Pan-Maciek/k60/pcb/k60.brd

## EAGLE design pcb/k60.brd (2021-05-18)

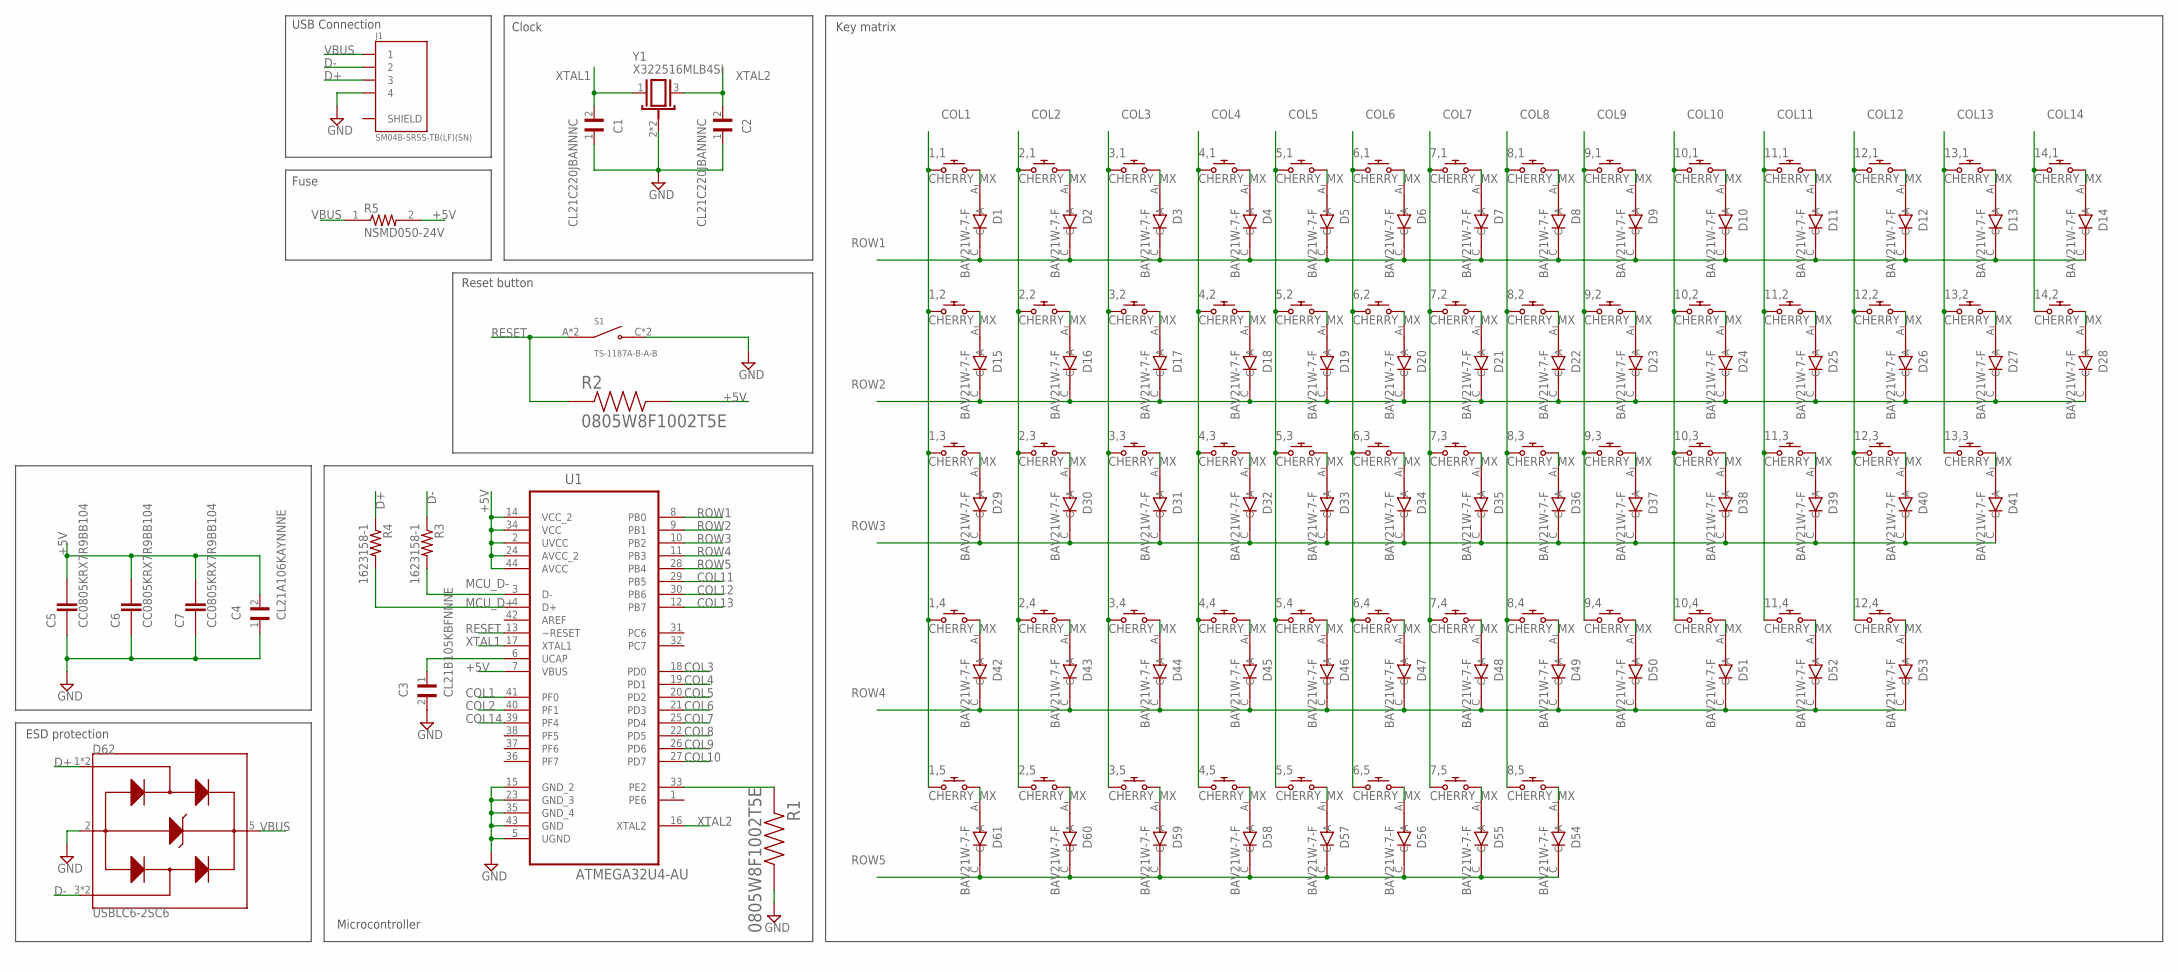
[picture p1: schematic k60.sch]

Parts:
1,1, 1,2, 1,3, 1,4, 1,5, 2,1, 2,2, 2,3, 2,4, 2,5, 3,1, 3,2, 3,3, 3,4, 3,5, 4,1, 4,2, 4,3, 4,4, 4,5, 5,1, 5,2, 5,3, 5,4, 5,5, 6,1, 6,2, 6,3, 6,4, 6,5, 7,1, 7,2, 7,3, 7,4, 7,5, 8,1, 8,2, 8,3, 8,4, 8,5, 9,1, 9,2, 9,3, 9,4, 10,1, 10,2, 10,3, 10,4, 11,1, 11,2, 11,3, 11,4, 12,1, 12,2, 12,3, 12,4, 13,1, 13,2, 13,3, 14,1, 14,2: CHERRY_MX
C1, C2: CL21C220JBANNNC; CAPC2012X140N
C3: CL21B105KBFNNNE; CL21B105KBFNNNE_CAPC2012X140N
C4: CL21A106KAYNNNE; CAPC2012X135N
C5, C6, C7: CC0805KRX7R9BB104; CAPC2012X70
D1, D2, D3, D4, D5, D6, D7, D8, D9, D10, D11, D12, D13, D14, D15, D16, D17, D18, D19, D20, D21, D22, D23, D24, D25, D26, D27, D28, D29, D30, D31, D32, D33, D34, D35, D36, D37, D38, D39, D40, D41, D42, D43, D44, D45, D46, D47, D48, D49, D50, D51, D52, D53, D54, D55, D56, D57, D58, D59, D60, D61: BAV21W-7-F; SOD3715X135N
D62: USBLC6-2SC6; SOT95P280X145-6N
J1: SM04B-SRSS-TB(LF)(SN); JST_SM04B-SRSS-TB(LF)(SN)
R1, R2: 0805W8F1002T5E; RESC2012X60N
R3, R4: 1623158-1; RESC2012X65N
R5: NSMD050-24V; RESC3115X65N
S1: TS-1187A-B-A-B; SW_TS-1187A-B-A-B
U1: ATMEGA32U4-AU; QFP80P1200X1200X120-44N
Y1: X322516MLB4SI; OSC_X322516MLB4SI

Connections:
+5V: C4.2, C5.2, C6.2, C7.2, R2.2, R5.2, U1.2 (UVCC), U1.7 (VBUS), U1.14 (VCC_2), U1.24 (AVCC_2), U1.34 (VCC), U1.44 (AVCC)
COL1: 1,1.S1 (1), 1,2.S1 (1), 1,3.S1 (1), 1,4.S1 (1), 1,5.S1 (1), U1.41 (PF0)
COL2: 2,1.S1 (1), 2,2.S1 (1), 2,3.S1 (1), 2,4.S1 (1), 2,5.S1 (1), U1.40 (PF1)
COL3: 3,1.S1 (1), 3,2.S1 (1), 3,3.S1 (1), 3,4.S1 (1), 3,5.S1 (1), U1.18 (PD0)
COL4: 4,1.S1 (1), 4,2.S1 (1), 4,3.S1 (1), 4,4.S1 (1), 4,5.S1 (1), U1.19 (PD1)
COL5: 5,1.S1 (1), 5,2.S1 (1), 5,3.S1 (1), 5,4.S1 (1), 5,5.S1 (1), U1.20 (PD2)
COL6: 6,1.S1 (1), 6,2.S1 (1), 6,3.S1 (1), 6,4.S1 (1), 6,5.S1 (1), U1.21 (PD3)
COL7: 7,1.S1 (1), 7,2.S1 (1), 7,3.S1 (1), 7,4.S1 (1), 7,5.S1 (1), U1.25 (PD4)
COL8: 8,1.S1 (1), 8,2.S1 (1), 8,3.S1 (1), 8,4.S1 (1), 8,5.S1 (1), U1.22 (PD5)
COL9: 9,1.S1 (1), 9,2.S1 (1), 9,3.S1 (1), 9,4.S1 (1), U1.26 (PD6)
COL10: 10,1.S1 (1), 10,2.S1 (1), 10,3.S1 (1), 10,4.S1 (1), U1.27 (PD7)
COL11: 11,1.S1 (1), 11,2.S1 (1), 11,3.S1 (1), 11,4.S1 (1), U1.29 (PB5)
COL12: 12,1.S1 (1), 12,2.S1 (1), 12,3.S1 (1), 12,4.S1 (1), U1.30 (PB6)
COL13: 13,1.S1 (1), 13,2.S1 (1), 13,3.S1 (1), U1.12 (PB7)
COL14: 14,1.S1 (1), 14,2.S1 (1), U1.39 (PF4)
D+: D62.1 (I/O1), D62.6 (I/O1), J1.3, R4.1
D-: D62.3 (I/O2), D62.4 (I/O2), J1.2, R3.1
GND: C1.1, C2.1, C3.2, C4.1, C5.1, C6.1, C7.1, D62.2 (GND), J1.4, R1.2, S1.C (NO), S1.D (NO), U1.5 (UGND), U1.15 (GND_2), U1.23 (GND_3), U1.35 (GND_4), U1.43 (GND), Y1.2 (GND), Y1.4 (GND)
MCU_D+: R4.2, U1.4 (D+)
MCU_D-: R3.2, U1.3 (D-)
unnamed: C3.1, U1.6 (UCAP)
unnamed: R1.1, U1.33 (PE2)
unnamed: 1,1.S2 (2), D1.A
unnamed: 2,1.S2 (2), D2.A
unnamed: 3,1.S2 (2), D3.A
unnamed: 4,1.S2 (2), D4.A
unnamed: 5,1.S2 (2), D5.A
unnamed: 6,1.S2 (2), D6.A
unnamed: 7,1.S2 (2), D7.A
unnamed: 8,1.S2 (2), D8.A
unnamed: 9,1.S2 (2), D9.A
unnamed: 10,1.S2 (2), D10.A
unnamed: 11,1.S2 (2), D11.A
unnamed: 12,1.S2 (2), D12.A
unnamed: 13,1.S2 (2), D13.A
unnamed: 14,1.S2 (2), D14.A
unnamed: 1,2.S2 (2), D15.A
unnamed: 2,2.S2 (2), D16.A
unnamed: 3,2.S2 (2), D17.A
unnamed: 4,2.S2 (2), D18.A
unnamed: 5,2.S2 (2), D19.A
unnamed: 6,2.S2 (2), D20.A
unnamed: 7,2.S2 (2), D21.A
unnamed: 8,2.S2 (2), D22.A
unnamed: 9,2.S2 (2), D23.A
unnamed: 10,2.S2 (2), D24.A
unnamed: 11,2.S2 (2), D25.A
unnamed: 12,2.S2 (2), D26.A
unnamed: 13,2.S2 (2), D27.A
unnamed: 1,3.S2 (2), D29.A
unnamed: 2,3.S2 (2), D30.A
unnamed: 3,3.S2 (2), D31.A
unnamed: 4,3.S2 (2), D32.A
unnamed: 5,3.S2 (2), D33.A
unnamed: 6,3.S2 (2), D34.A
unnamed: 7,3.S2 (2), D35.A
unnamed: 8,3.S2 (2), D36.A
unnamed: 9,3.S2 (2), D37.A
unnamed: 10,3.S2 (2), D38.A
unnamed: 11,3.S2 (2), D39.A
unnamed: 12,3.S2 (2), D40.A
unnamed: 13,3.S2 (2), D41.A
unnamed: 14,2.S2 (2), D28.A
unnamed: 1,4.S2 (2), D42.A
unnamed: 2,4.S2 (2), D43.A
unnamed: 3,4.S2 (2), D44.A
unnamed: 4,4.S2 (2), D45.A
unnamed: 5,4.S2 (2), D46.A
unnamed: 6,4.S2 (2), D47.A
unnamed: 7,4.S2 (2), D48.A
unnamed: 8,4.S2 (2), D49.A
unnamed: 9,4.S2 (2), D50.A
unnamed: 10,4.S2 (2), D51.A
unnamed: 11,4.S2 (2), D52.A
unnamed: 12,4.S2 (2), D53.A
unnamed: 1,5.S2 (2), D61.A
unnamed: 2,5.S2 (2), D60.A
unnamed: 3,5.S2 (2), D59.A
unnamed: 4,5.S2 (2), D58.A
unnamed: 5,5.S2 (2), D57.A
unnamed: 6,5.S2 (2), D56.A
unnamed: 7,5.S2 (2), D55.A
unnamed: 8,5.S2 (2), D54.A
RESET: R2.1, S1.A (COM), S1.B (COM), U1.13 (~RESET)
ROW1: D1.C, D2.C, D3.C, D4.C, D5.C, D6.C, D7.C, D8.C, D9.C, D10.C, D11.C, D12.C, D13.C, D14.C, U1.8 (PB0)
ROW2: D15.C, D16.C, D17.C, D18.C, D19.C, D20.C, D21.C, D22.C, D23.C, D24.C, D25.C, D26.C, D27.C, D28.C, U1.9 (PB1)
ROW3: D29.C, D30.C, D31.C, D32.C, D33.C, D34.C, D35.C, D36.C, D37.C, D38.C, D39.C, D40.C, D41.C, U1.10 (PB2)
ROW4: D42.C, D43.C, D44.C, D45.C, D46.C, D47.C, D48.C, D49.C, D50.C, D51.C, D52.C, D53.C, U1.11 (PB3)
ROW5: D54.C, D55.C, D56.C, D57.C, D58.C, D59.C, D60.C, D61.C, U1.28 (PB4)
VBUS: D62.5 (VBUS), J1.1, R5.1
XTAL1: C1.2, U1.17 (XTAL1), Y1.1
XTAL2: C2.2, U1.16 (XTAL2), Y1.3

Notes on the sheet:
Clock
USB Connection
Reset button
Key matrix
Fuse
ESD protection
Microcontroller

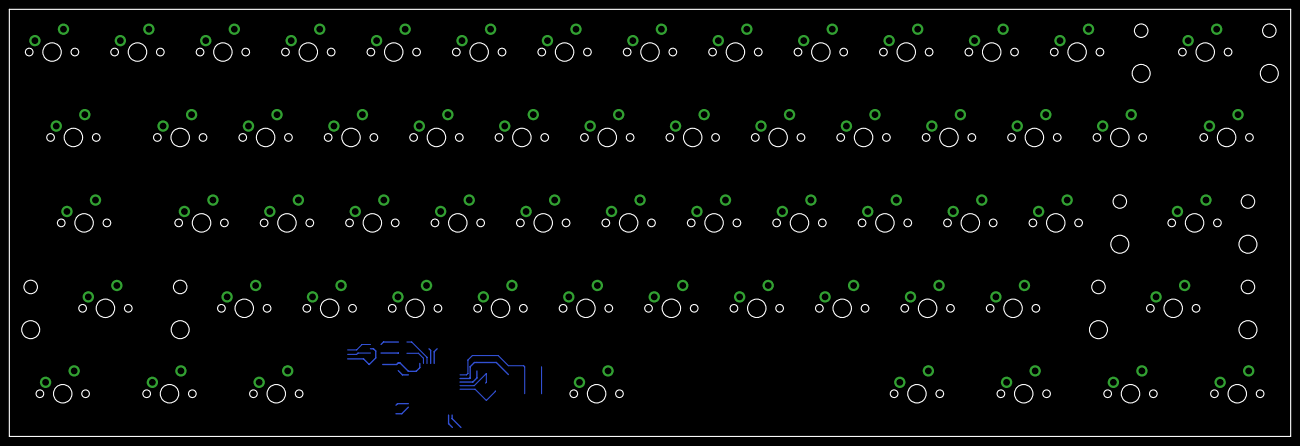
[picture p2: board k60.brd from above]

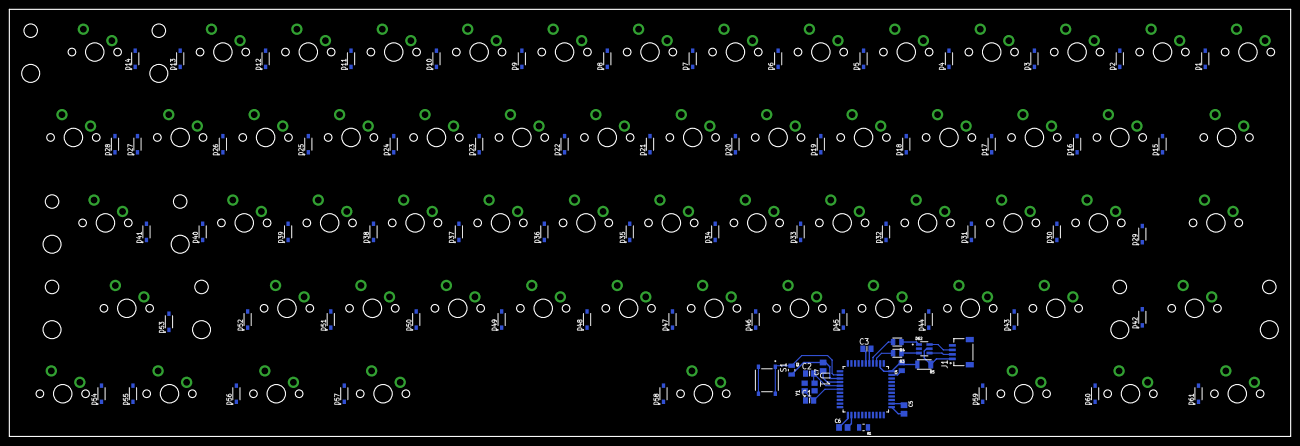
[picture p3: board k60.brd from below]

Board: 2 copper layers, 285.0 x 95.0 mm, 139 parts (78 on the bottom side), 92 nets.
