Pan-Maciek/k60/(commit log)

2021-04-17 basic board outline
    TODO:
    * Center LShift, Enter, RShift and whole ROW5
    * Place stabilizer holes
    * Add mounting points for case
    * Connect crystal
    * Add fuse
    [k60.brd, k60.sch]
2021-04-17 aligned missaligned keys
    [k60.brd]
2021-04-17 fixed board dimensions, mx_switch
    original mx_switch component was using layer 20 (Dimension)
    layer 20 is used to determine pcb surface
    moved outline from layer 20 to layer 51 (tDocu)
    hint:
    to update component lib add new component from this lib in .sch file
    added rough pcb dimension and mounting points for stabilizers
    TODO: add mounting case mounting points
    [k60.brd, k60.sch]
2021-04-19 changed lib to custom k60 lib
    [k60.brd, k60.sch]
2021-04-19 moved to positive coordinates
    [k60.brd]
2021-04-20 schematic cleanup, connected important compoonents
    added power stabilization (10uF, 1uF)
    [k60.brd, k60.sch]
2021-05-25 prototype works
2021-05-25 layer switching nie działa
